ushi002/taGps-Eagle/taGPS-1350.brd

## EAGLE design taGPS-1350.brd (2016-06-11)

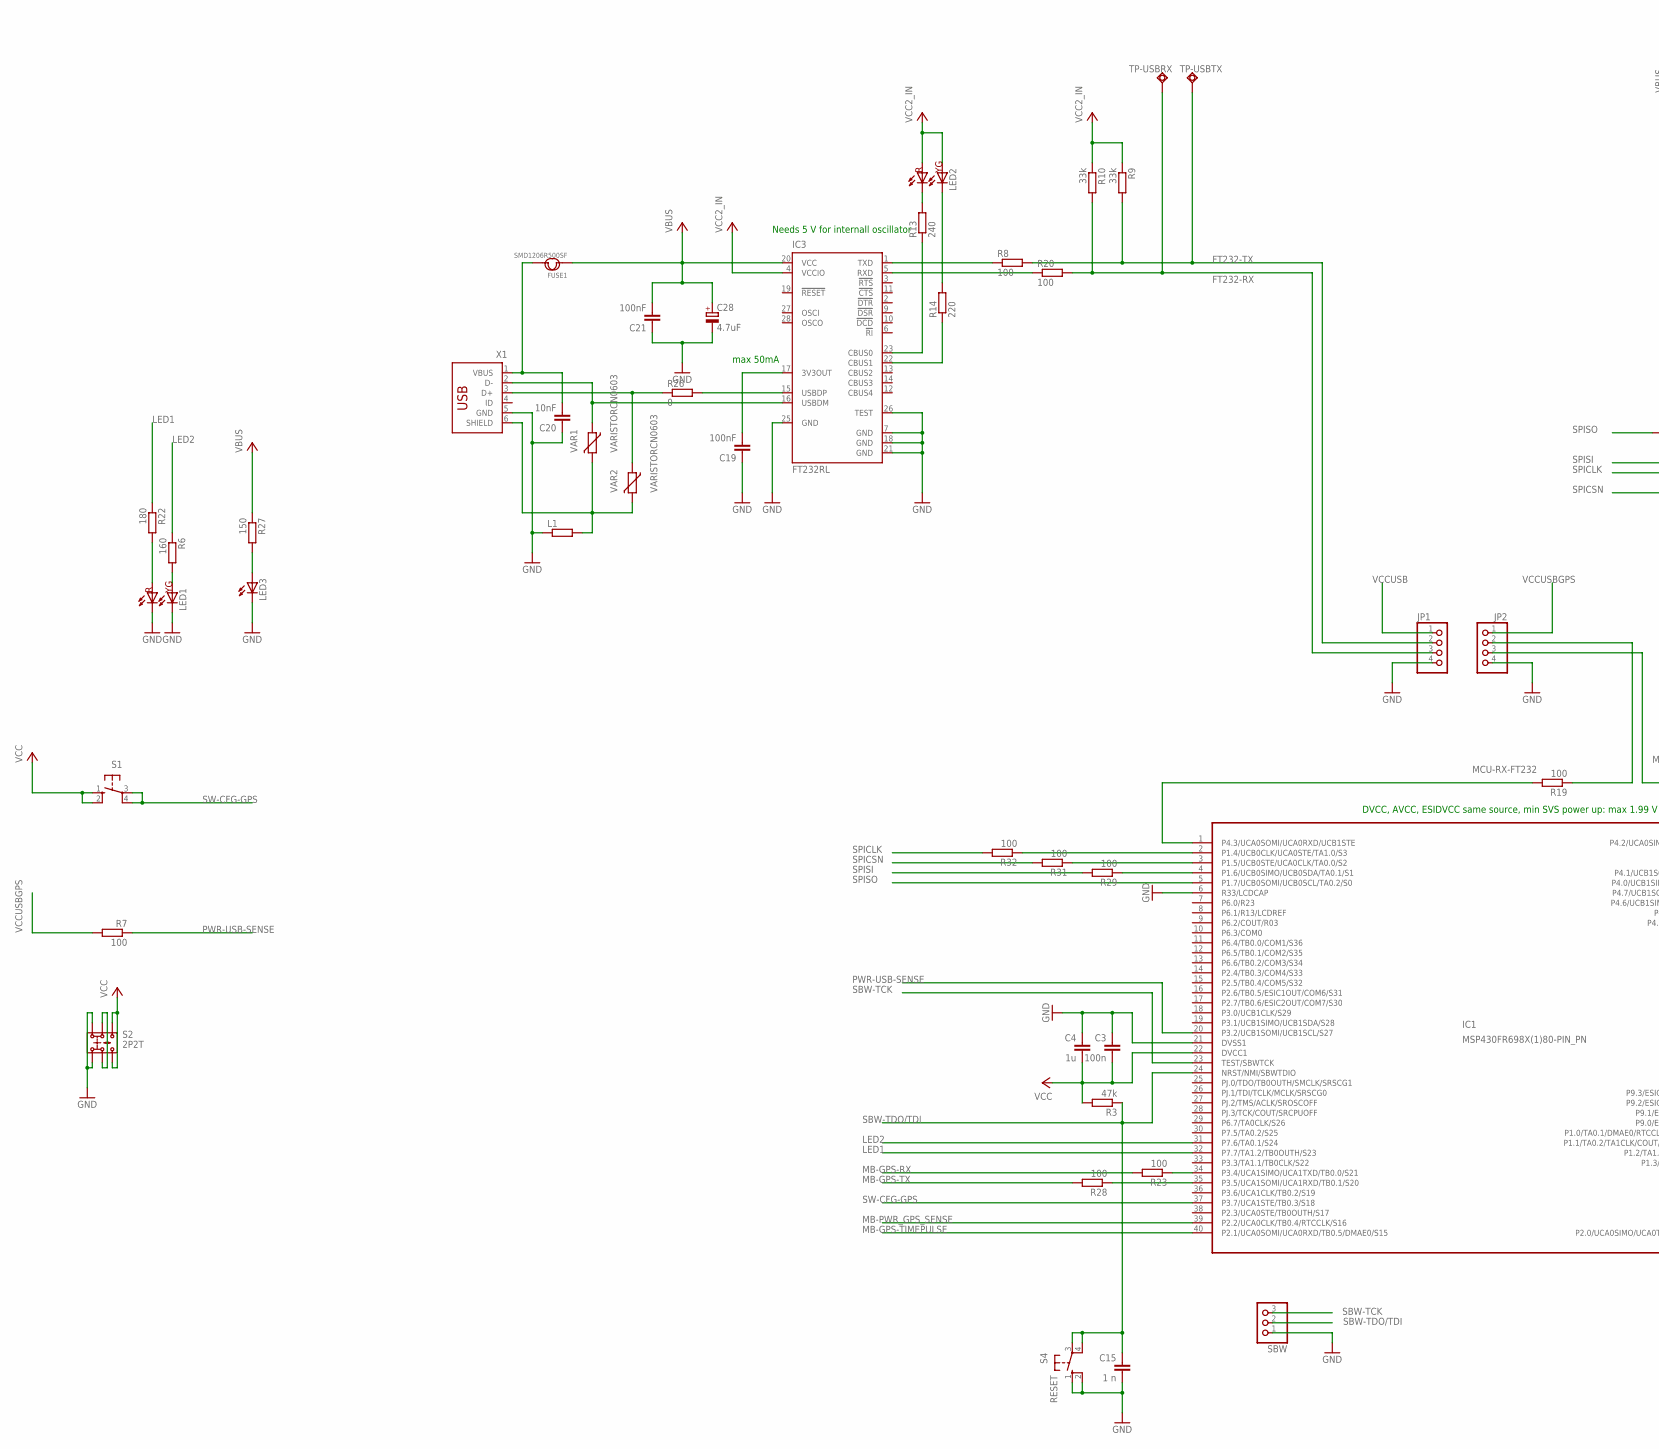
[picture p1: schematic taGPS-1350.sch, part in row 1, column 1]

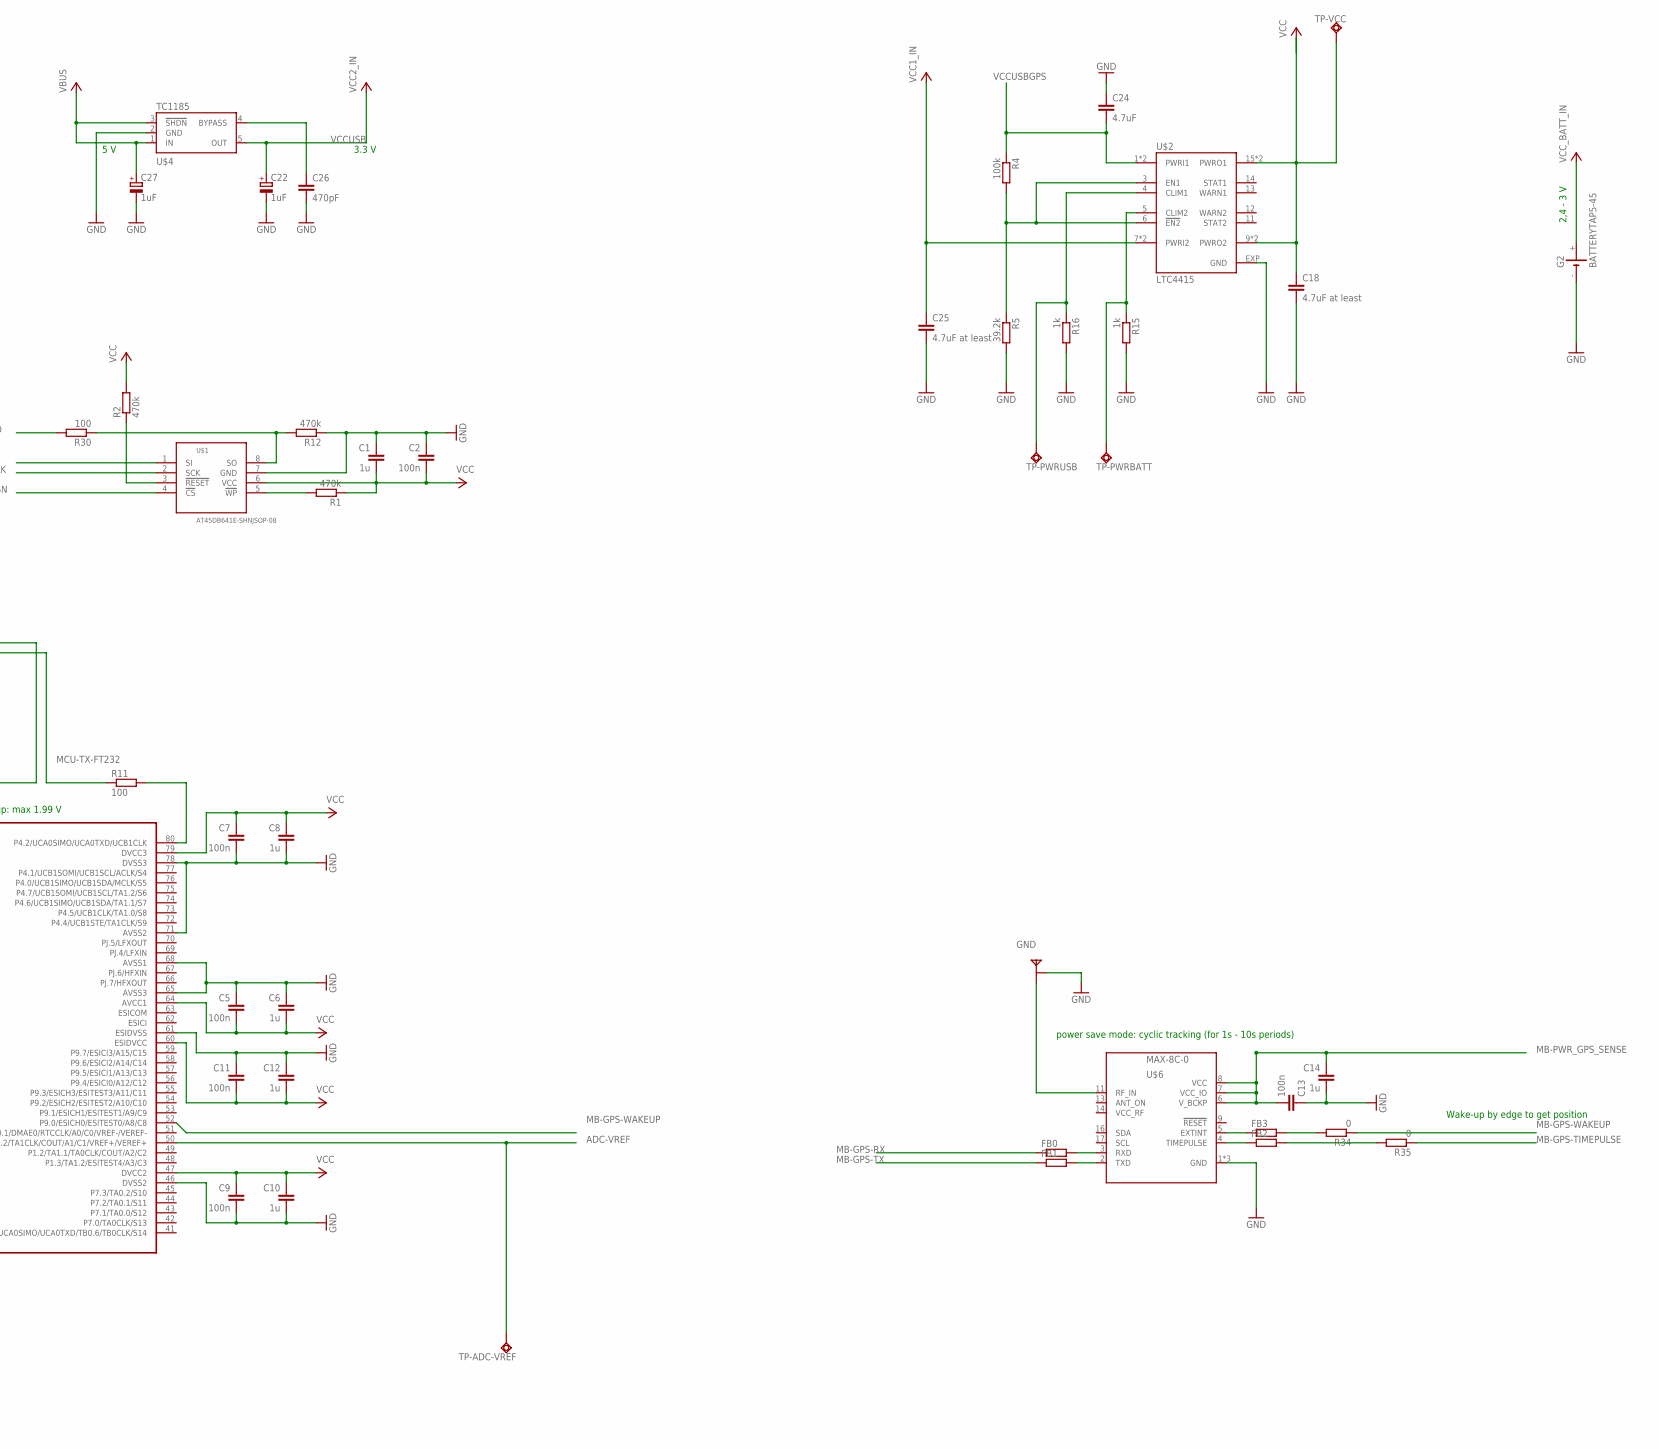
[picture p2: schematic taGPS-1350.sch, part in row 1, column 2]

Parts:
C1, C4, C6, C8, C10, C12, C14: 1u; C0603
C2, C3, C5, C7, C9, C11, C13: 100n; C0603
C15: 1 n; C0603
C18, C25: 4.7uF at least; C0805
C19, C21: 100nF; C0603
C20: 10nF; C0603
C22, C27: 1uF; A/3216-18W
C24: 4.7uF; C0805
C26: 470pF; C0603
C28: 4.7uF; A/3216-18W
FB0, FB1, FB2, FB3: R-EU_R0402; R0402
FUSE1: SMD1206R500SF; F1812
G2: BATTERYTAP5-45; TAP5-45
IC1: MSP430FR698X(1)80-PIN_PN; PN_S-PQFP-G80
IC3: FT232RL; SSOP28
JP1, JP2: PINHD-1X4; 1X04
L1: R-EU_R0603; R0603
LED1, LED2: BILEDBILED; BILED
LED3: LED_E; LED_KINGBRIGHT0603
R1, R2, R12: 470k; R0603
R3: 47k; R0603
R4: 100k; R0603
R5: 39.2k; R0603
R6: 160; R0603
R7, R8, R11, R19, R20, R23, R28, R29, R30, R31, R32: 100; R0603
R9, R10: 33k; R0603
R13: 240; R0603
R14: 220; R0603
R15, R16: 1k; R0603
R22: 180; R0603
R26, R34, R35: 0; R0603
R27: 150; R0603
S1: SWITCH-10-XX; B3F-10XX
S2: 2P2T
S4: RESET; B3F-10XX
SBW: PINHD-1X3; 1X03
TP-ADC-VREF: TPSQTP10R; TP10R
TP-PWRBATT: TPSQTP10R; TP10R
TP-PWRUSB: TPSQTP10R; TP10R
TP-USBRX: TPSQPAD1-13; P1-13
TP-USBTX: TPSQPAD1-13; P1-13
TP-VCC: TPSQTP10R; TP10R
U$1: AT45DB641E-SHNJSOP-08; JSOP-08
U$2: LTC4415; MSOP16
U$4: TC1185; SOT23-5
U$5: MWSL1251MWSL1350; MWSL1350
U$6: MAX-8C-0; MAX-8
VAR1, VAR2: VARISTORCN0603; CT/CN0603
X1: USB-787616; USB

Connections:
ADC-BATT: R15.1, TP-PWRBATT.TP, U$2.5 (CLIM2)
ADC-VREF: IC1.50 (P1.1/TA0.2/TA1CLK/COUT/A1/C1/VREF+/VERE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), TP-ADC-VREF.TP
FT232-RX: JP1.3, R10.2, R20.2, TP-USBRX.TP
FT232-TX: JP1.2, R8.2, R9.2, TP-USBTX.TP
GND: C1.1, C2.1, C3.1, C4.1, C5.1, C6.1, C7.2, C8.2, C9.2, C10.2, C11.1, C12.1, C13.1, C14.2, C15.2, C18.2, C19.1, C20.1, C21.1, C22.-, C24.1, C25.2, C26.2, C27.-, C28.-, G2.-, IC1.6 (R33/LCDCAP), IC1.21 (DVSS1), IC1.46 (DVSS2), IC1.61 (ESIDVSS), IC1.65 (AVSS3), IC1.68 (AVSS1), IC1.71 (AVSS2), IC1.78 (DVSS3), IC3.7 (GND), IC3.18 (GND), IC3.21 (GND), IC3.25 (GND), IC3.26 (TEST), JP1.4, JP2.4, L1.1, LED1.1, LED1.3, LED3.C, R5.2, R12.1, R15.2, R16.2, S2.1.1, S2.1.2, S4.1 (S), S4.2 (S1), SBW.1, U$1.7 (GND), U$2.EXP (GND), U$4.2 (GND), U$5.P$1 (GND), U$5.P$3 (GND), U$6.1 (GND), U$6.10 (GND), U$6.12 (GND), X1.5 (GND)
LED1: IC1.32 (P7.7/TA1.2/TB0OUTH/S23), R22.1
LED2: IC1.31 (P7.6/TA0.1/S24), R6.1
MB-GPS-RX: FB0.1, R23.2
MB-GPS-TIMEPULSE: IC1.40 (P2.1/UCA0SOMI/UCA0RXD/TB0.5/DMAE0/S15), R35.1
MB-GPS-TX: FB1.1, R28.2
MB-GPS-WAKEUP: IC1.52 (P9.0/ESICH0/ESITEST0/A8/C8), R34.1
MB-PWR_GPS_SENSE: C13.2, C14.1, IC1.39 (P2.2/UCA0CLK/TB0.4/RTCCLK/S16), S2.2.1, S2.2.2, U$6.6 (V_BCKP), U$6.7 (VCC_IO), U$6.8 (VCC)
MCU-RX-FT232: IC1.1 (P4.3/UCA0SOMI/UCA0RXD/UCB1STE), R19.2
MCU-TX-FT232: JP2.3, R11.1
unnamed: IC3.1 (TXD), R8.1
unnamed: IC1.80 (P4.2/UCA0SIMO/UCA0TXD/UCB1CLK), R11.2
unnamed: IC1.4 (P1.6/UCB0SIMO/UCB0SDA/TA0.1/S1), R29.1
unnamed: IC3.5 (RXD), R20.1
unnamed: R2.1, U$1.3 (!RESET)
unnamed: R4.2, R5.1, U$2.3 (EN1), U$2.6 (!EN2)
unnamed: JP2.2, R19.1
unnamed: C19.2, IC3.17 (3V3OUT)
unnamed: R1.2, U$1.5 (!WP)
unnamed: R26.1, VAR2.1, X1.3 (D+)
unnamed: IC3.16 (USBDM), VAR1.1, X1.2 (D-)
unnamed: R12.2, R30.1, U$1.8 (SO)
unnamed: FB0.2, U$6.3 (RXD)
unnamed: IC3.23 (CBUS0), R13.1
unnamed: IC3.22 (CBUS1), R14.1
unnamed: LED2.1, R13.2
unnamed: LED2.3, R14.2
unnamed: C20.2, FUSE1.2, X1.1 (VBUS)
unnamed: L1.2, VAR1.2, VAR2.2, X1.6 (SHIELD)
unnamed: IC1.2 (P1.4/UCB0CLK/UCA0STE/TA1.0/S3), R32.1
unnamed: R16.1, TP-PWRUSB.TP, U$2.4 (CLIM1)
unnamed: FB1.2, U$6.2 (TXD)
unnamed: U$5.P$2 (FEED), U$6.11 (RF_IN)
unnamed: IC3.15 (USBDP), R26.2
unnamed: C26.1, U$4.4 (BYPASS)
unnamed: LED1.4, R6.2
unnamed: LED1.2, R22.2
unnamed: IC1.3 (P1.5/UCB0STE/UCA0CLK/TA0.0/S2), R31.1
unnamed: IC1.34 (P3.4/UCA1SIMO/UCA1TXD/TB0.0/S21), R23.1
unnamed: LED3.A, R27.2
unnamed: IC1.35 (P3.5/UCA1SOMI/UCA1RXD/TB0.1/S20), R28.1
unnamed: FB3.2, R34.2
unnamed: FB2.2, R35.2
unnamed: FB2.1, U$6.4 (TIMEPULSE)
unnamed: FB3.1, U$6.5 (EXTINT)
PWR-USB-SENSE: IC1.20 (P3.2/UCB1SOMI/UCB1SCL/S27), R7.1
SBW-TCK: IC1.23 (TEST/SBWTCK), SBW.3
SBW-TDO/TDI: C15.1, IC1.24 (NRST/NMI/SBWTDIO), R3.1, S4.3, S4.4 (P1), SBW.2
SPICLK: R32.2, U$1.2 (SCK)
SPICSN: R31.2, U$1.4 (!CS)
SPISI: R29.2, U$1.1 (SI)
SPISO: IC1.5 (P1.7/UCB0SOMI/UCB0SCL/TA0.2/S0), R30.2
SW-CFG-GPS: IC1.37 (P3.7/UCA1STE/TB0.3/S18), S1.3, S1.4 (P1)
VBUS: C21.2, C27.+, C28.+, FUSE1.1, IC3.20 (VCC), R27.1, U$4.1 (IN), U$4.3 (!SHDN)
VCC: C1.2, C2.2, C3.2, C4.2, C5.2, C6.2, C7.1, C8.1, C9.1, C10.1, C11.2, C12.2, C18.1, IC1.22 (DVCC1), IC1.47 (DVCC2), IC1.60 (ESIDVCC), IC1.64 (AVCC1), IC1.79 (DVCC3), R1.1, R2.2, R3.2, S1.1 (S), S1.2 (S1), S2.3.1, S2.3.2, TP-VCC.TP, U$1.6 (VCC), U$2.9 (PWRO2), U$2.10 (PWRO2), U$2.15 (PWRO1), U$2.16 (PWRO1)
VCCUSB: C22.+, IC3.4 (VCCIO), JP1.1, LED2.2, LED2.4, R9.1, R10.1, U$4.5 (OUT)
VCCUSBGPS: C24.2, JP2.1, R4.1, R7.2, U$2.1 (PWRI1), U$2.2 (PWRI1)
VCC_BATT_IN: C25.1, G2.+, U$2.7 (PWRI2), U$2.8 (PWRI2)

Notes on the sheet:
2,4 - 3 V
DVCC, AVCC, ESIDVCC same source, min SVS power up: max 1.99 V
Needs 5 V for internall oscillator
5 V
3.3 V
max 50mA
power save mode: cyclic tracking (for 1s - 10s periods)
Wake-up by edge to get position

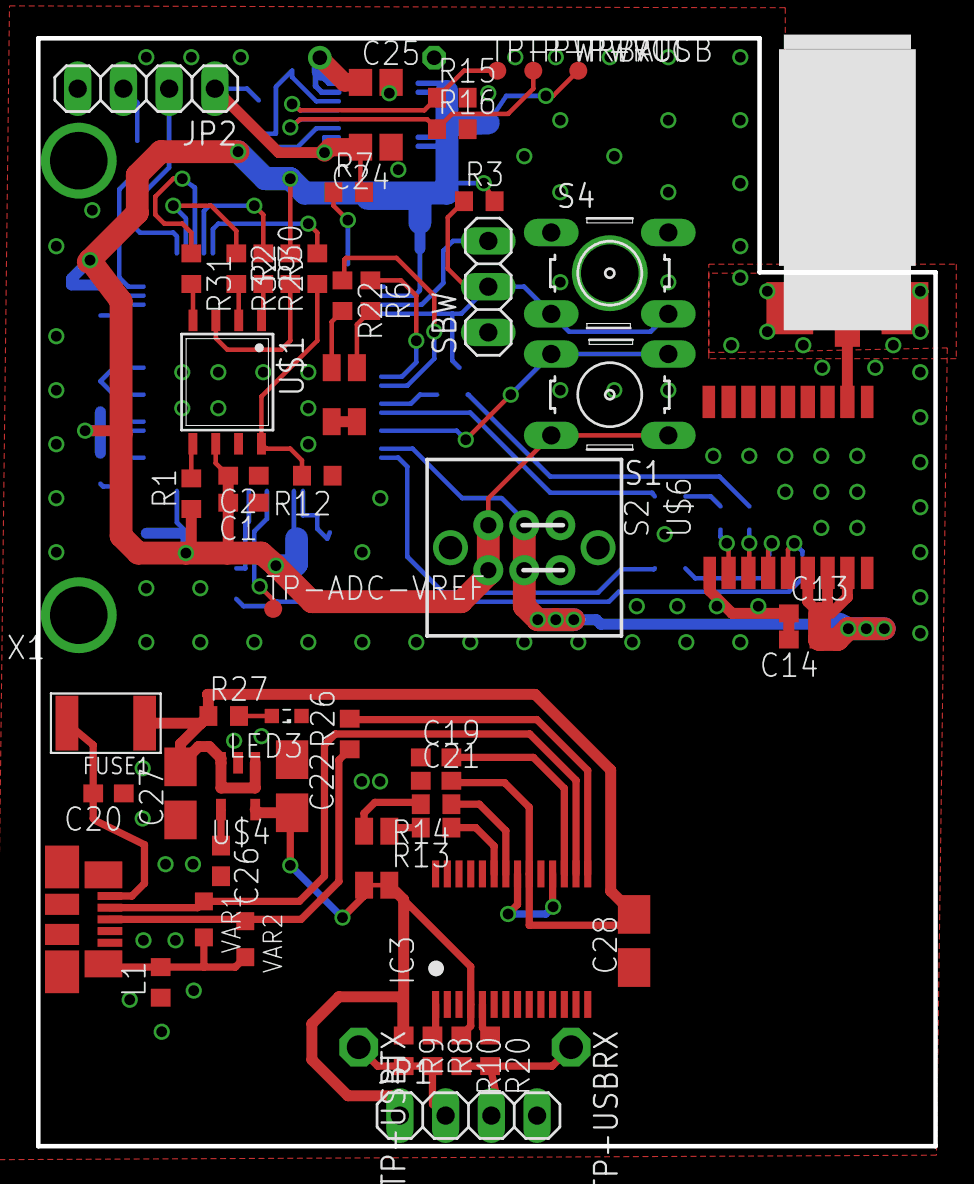
[picture p3: board taGPS-1350.brd from above]

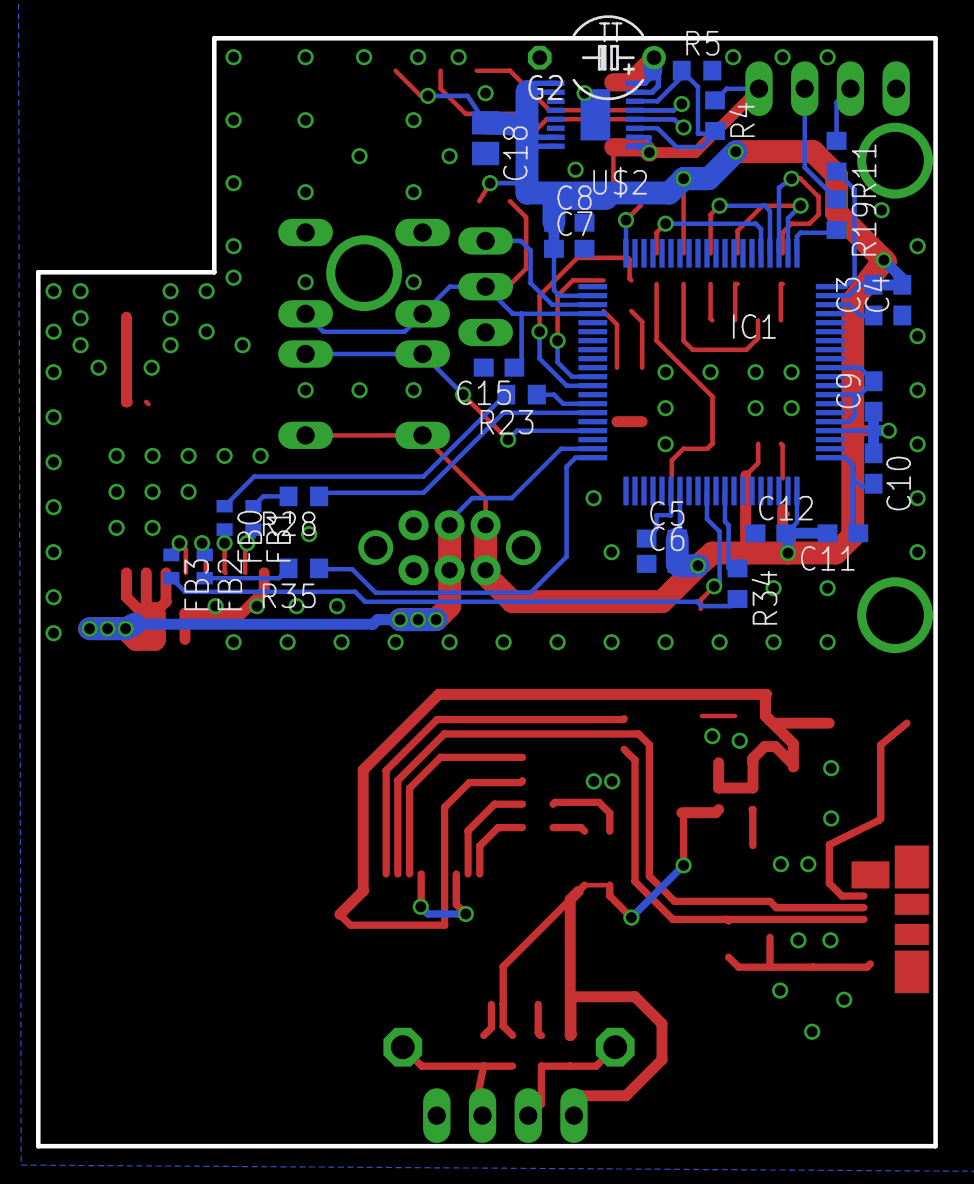
[picture p4: board taGPS-1350.brd from below]

Board: 2 copper layers, 49.9 x 61.5 mm, 86 parts (27 on the bottom side), 62 nets.
