ushi002/taGps-Eagle/(commit log)

2015-01-27 Initial commit - TAGPS eagle scheme and board almost done
    [revision0.brd, revision0.sch]
2015-01-28 Compress board space to minimum, place battery holder
    [revision0.brd]
2015-01-30 The board is almost done
    [revision0.brd, revision0.sch]
2015-04-03 Added GPS chip, board mostly done, prepare for order
    [revision0.brd, revision0.sch]
2015-04-09 Check DRC, fix overlaps, clearence
    [revision0.brd]
2015-04-14 Fix few clearances
    [revision0.brd]
2015-04-16 Improve board for pcb factory
    [revision0.brd, revision0.sch]
2015-04-16 Fix clearance values, improve brd texts
    [revision0.brd, revision0.sch]
2015-04-29 Change USB.pac text layer
    [revision0.brd, revision0.sch]
2015-05-20 Fix msp430f5437 SMD PADs missing stop layer
    [revision0.brd, revision0.sch]
2015-05-20 Turn on polygon thermals and fix one GND wire
    [revision0.brd]
2015-12-27 Move GPS-TIMEPULSE sig to interrupt capable input (P2.1)
    [revision0.brd, revision0.sch]
2016-01-27 Redesign a lot GPS RF part, CPU pins
    [revision0.brd, revision0.sch]
2016-01-28 Patch antenna module done
    [revision0.brd, revision0.sch]
2016-01-28 Fix CANAL sliding switch
    [revision0.brd, revision0.sch]
2016-01-29 Add MWSL1251 antenna to taGPS library
2016-01-29 Add MWSL1251 antenna to taGPS design
    [revision0.brd, revision0.sch]
2016-01-29 Small board tuning
    [revision0.brd]
2016-01-30 Rotate connector of patch antenna
    [revision0.brd]
2016-01-31 Add ceramic antenna, move the patch antenna connetor a bit
    [revision0.brd, revision0.sch]
2016-01-31 Fix gps-power switch scheme
    [revision0.brd, revision0.sch]
2016-02-01 More PCB board tuning
    [revision0.brd, revision0.sch]
2016-03-16 fix power-switcher voltage divider resistor value
    [revision0.brd, revision0.sch]
2016-03-16 Add text TST-RST-GND to pcb program pins
    [revision0.brd]
2016-03-31 Fix SPI flash package foot print on PCB
    [revision0.brd, revision0.sch]
2016-03-31 Resize Cc and Rs from 0805->0603
    [revision0.brd, revision0.sch]
2016-04-05 Split board to 2 pieces, remove ADC battery input (was senseless)
    [revision0.brd, revision0.sch]
2016-04-05 Remove UART pullups and button to make it even smaller
    Removed GPS and USB pullups (do not forget to add them
    to the MCU IOs!), removed one button, removed unnecesary
    GPS ferrite beads
    [revision0.brd, revision0.sch]
2016-04-06 Add design with MWSL1350 antenna
    [taGPS-1350.brd, taGPS-1350.sch]
2016-04-06 Add design with MWSL1251 antenna
    [taGPS-1251.brd, taGPS-1251.sch]
2016-04-11 Fix MCU RX/TX pinheader position, polish boards
    [taGPS-1251.brd, taGPS-1251.sch, taGPS-1350.brd, taGPS-1350.sch]
2016-04-12 Add seeed FUSE 1812 to library
2016-04-12 Replace FUSE package to 1812
    [taGPS-1251.brd, taGPS-1251.sch, taGPS-1350.brd, taGPS-1350.sch]
2016-04-12 Add panel-gps.brd (v1350 and v1251 for manufacturing)
    [panel-gps.brd]
2016-04-20 Check rules acc seeed studio
    [taGPS-1251.brd, taGPS-1251.sch, taGPS-1350.brd, taGPS-1350.sch]
2016-04-20 Little panel tuning
    [panel-gps.brd]
2016-04-22 Redesign type 1350 to get wider copper plane for antenna
    [taGPS-1350.brd, taGPS-1350.sch]
2016-04-22 Update panel-gps massively, add holes
    [panel-gps.brd]
2016-04-24 Tune panel-gps a bit more (move holes, add text)
    [panel-gps.brd]
2016-05-27 Fix panel-gps board connector signal labels
    [panel-gps.brd]
2016-05-29 Fix MWSL1350 antenna device package sizes
2016-05-29 Fix antenna position, grounding
    [taGPS-1350.brd, taGPS-1350.sch]
2016-05-30 Remove DC power shunts
    [taGPS-1350.brd, taGPS-1350.sch]
2016-06-01 Add Ferrite Beads for GPS chip, modify battery input
    For battery input one capacitor package was modified...
    [taGPS-1350.brd, taGPS-1350.sch]
2016-06-01 Add gps-1350-v0.31 board for manufacturer
    [gps-1350-manu.brd]
2016-06-03 Finish gps-1350-manu.brd and send it to china
    [gps-1350-manu.brd]
2016-06-03 Backport 1350-manu.brd to 1350 design
    [taGPS-1350.brd, taGPS-1350.sch]
2016-06-11 Fix 1350.brd timepulse resistor position
    [taGPS-1350.brd]
2016-06-11 Improve 1350.brd gps chip inductors position
    [taGPS-1350.brd]
